TransistorTun/Smart_Switch/Hardware/imagine/OIP.bmp

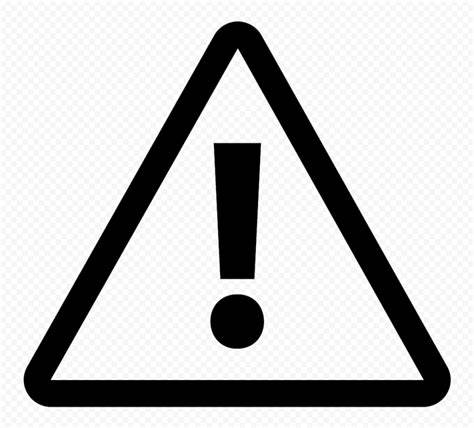
Hardware/imagine/OIP.bmp
