TransistorTun/Smart_Switch/Hardware/sche_v1.pdf

## 12V INPUT +DC

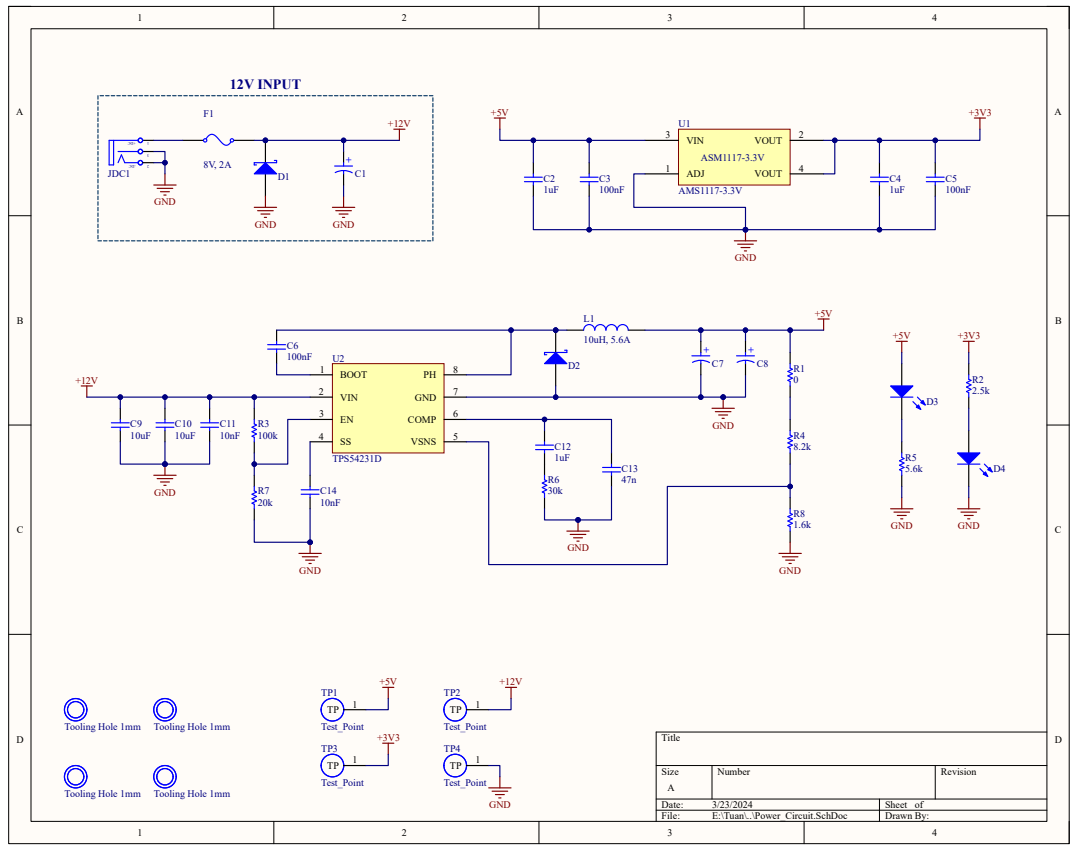
[picture p38: page 1]

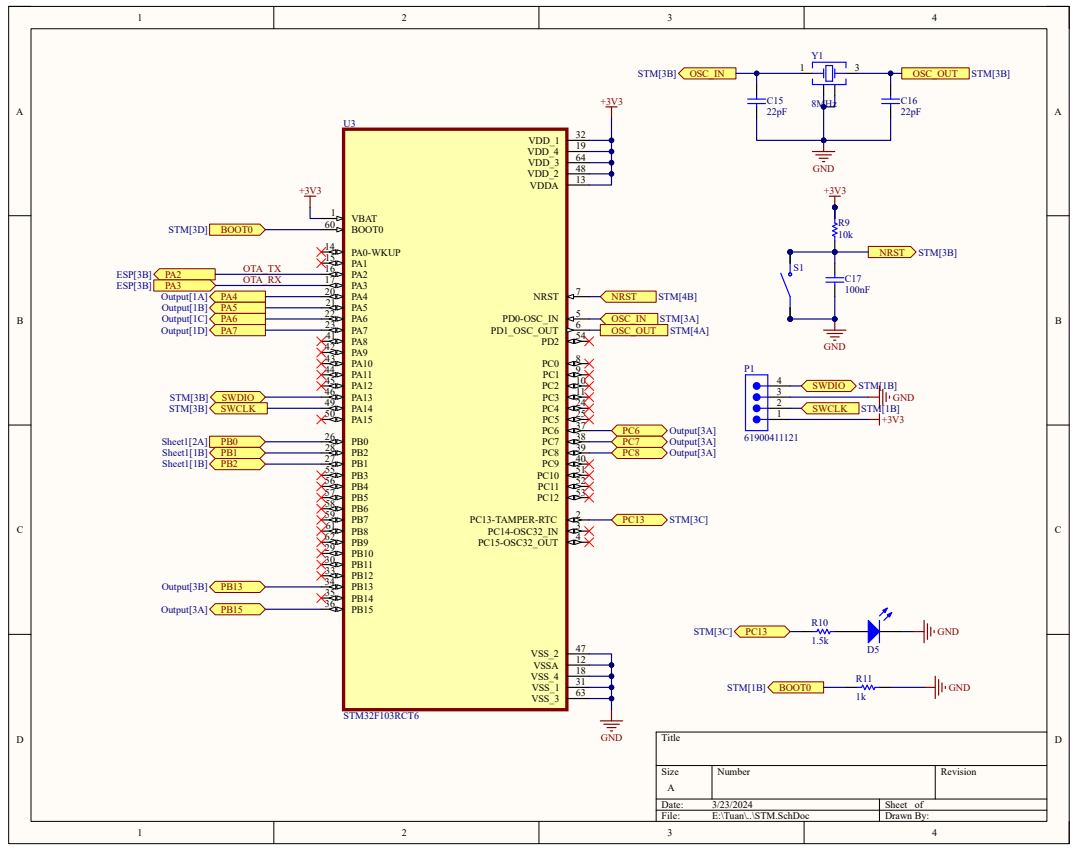
[picture p39: page 2]

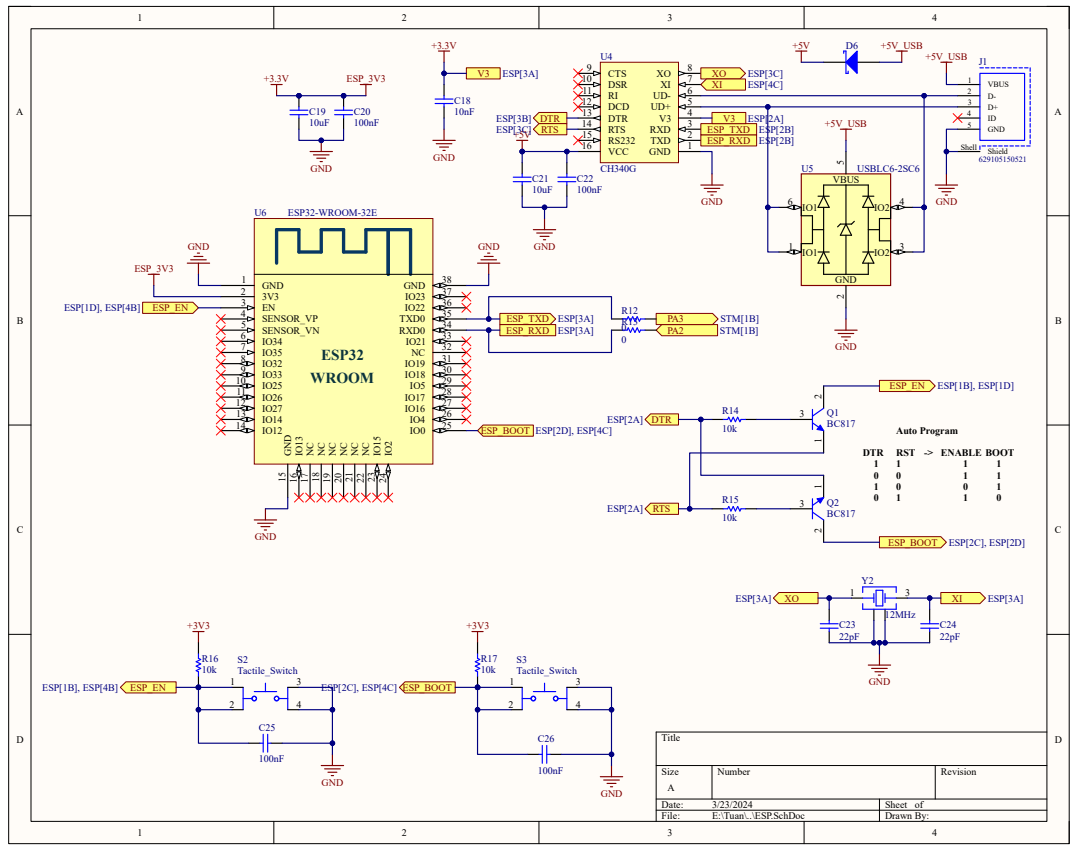
[picture p40: page 3]

SS2102 3 1

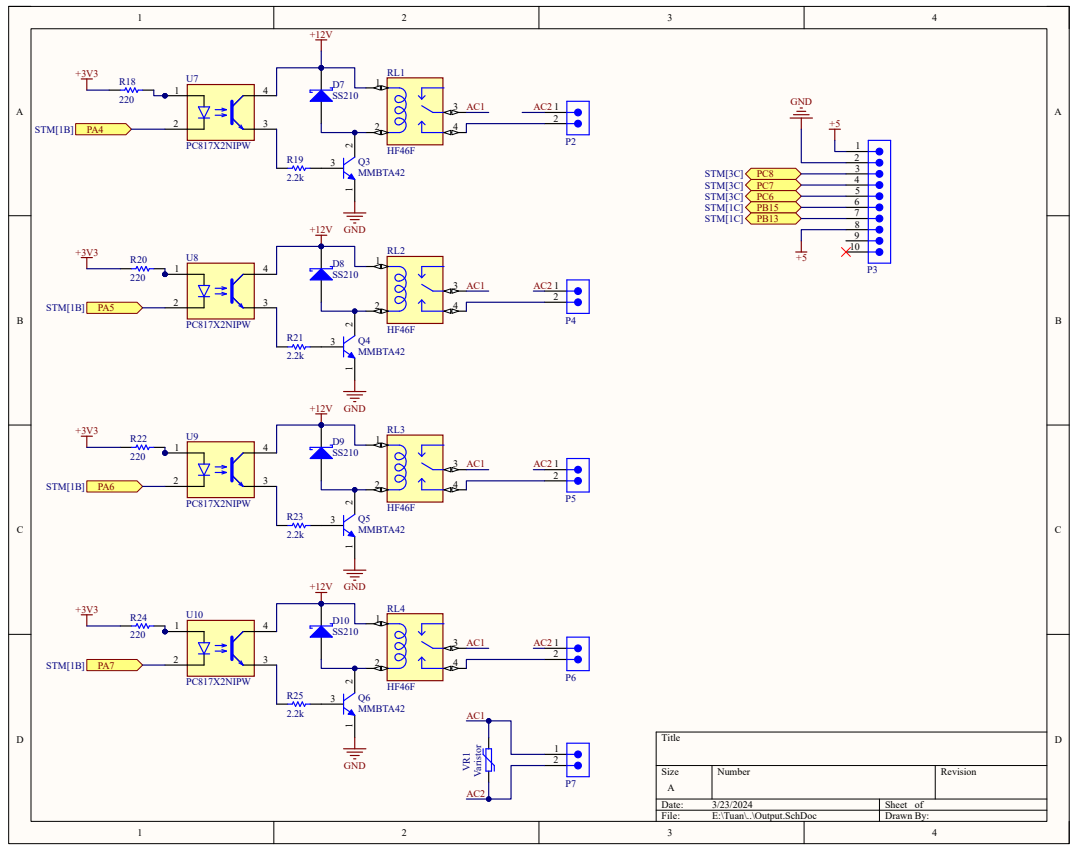
[picture p41: page 4]

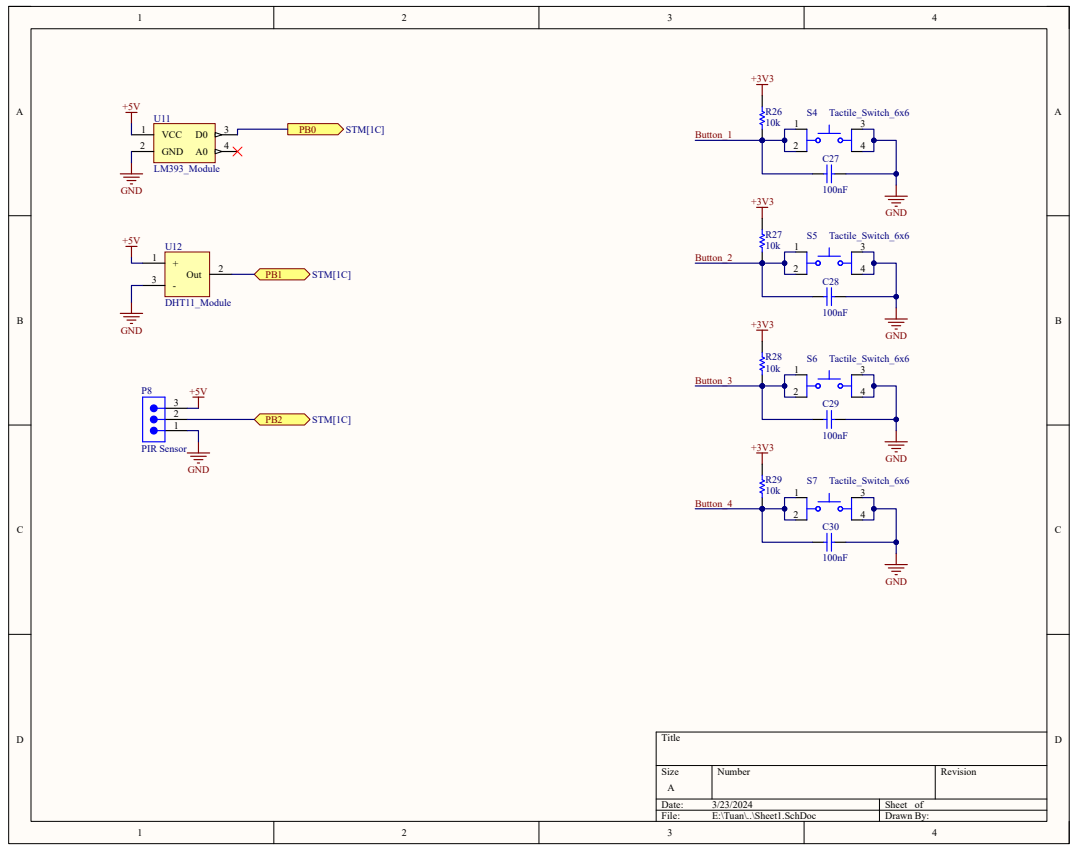
[picture p42: page 5]
