TransistorTun/Smart_Switch/(list of files, drawings)

Other design files:
Hardware/ESP.SchDoc
Hardware/Output.SchDoc
Hardware/Power_Circuit.SchDoc
Hardware/Power_Diagram.SchDoc
Hardware/Scripts/Delphiscript Scripts/PCB/PadViaExamples.PcbDoc
Hardware/Scripts/Delphiscript Scripts/PCB/PCB Iterators/Polygons.PcbDoc
Hardware/Scripts/Delphiscript Scripts/SCH/Connectivity/NetInfoPrj.PrjPCB
Hardware/Sheet1.SchDoc
Hardware/Smart_Home_v1.PrjPcb
Hardware/STM.SchDoc
Hardware/System_Diagram.SchDoc
