TransistorTun/Smart_Switch/firmware/stm32/BTL_LTN.ioc

Mcu.UserName=STM32F103RCTx
PA10.Signal=USART1_RX
PA13.Signal=SYS_JTMS-SWDIO
PA14.Signal=SYS_JTCK-SWCLK
PA4.Signal=GPIO_Output
PA5.Signal=GPIO_Output
PA6.Signal=GPIO_Output
PA7.Signal=GPIO_Output
PA9.Signal=USART1_TX
PB0.Signal=GPIO_Output
PB1.Signal=GPIO_Input
PB13.Signal=SPI2_SCK
PB15.Signal=SPI2_MOSI
PB2.Signal=GPIO_Input
PC0.Signal=GPXTI0
PC1.Signal=GPXTI1
PC2.Signal=GPXTI2
PC3.Signal=GPXTI3
PC6.Signal=GPIO_Output
PC7.Signal=GPIO_Output
PC8.Signal=GPIO_Output
PD0-OSC_IN.Signal=RCC_OSC_IN
PD1-OSC_OUT.Signal=RCC_OSC_OUT
