TransistorTun/Smart_Switch/(commit log)

2024-04-10 update hardware
    [BOM LIST.xlsx, ESP.SchDoc, NetInfoPrj.PrjPCB, Output.SchDoc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]
2024-04-24 update lung tung
    [ESP.SchDoc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]
